Ezecarp36/RobotLaberinto_G2/README.md

# RobotLaberinto_G2
Proyecto de robot laberinto para competir en la LNR 2023
