Ezecarp36/RobotLaberinto_G2/Hardware/Design_3D/Laberinto_G2.SLDASM

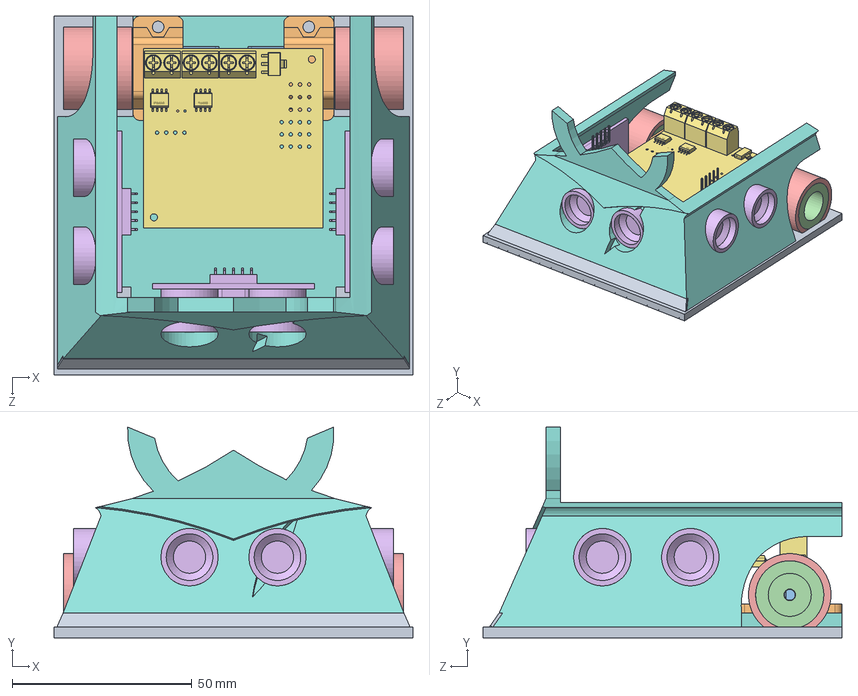
[picture p1: CAD file, 2023-11-03]
Hardware/Design_3D/Laberinto_G2.SLDASM
100.0 x 58.7 x 100.0 mm
Soporte_Motor_Pololu x 2
MicroMotor_500RPM
Llanta_V2 x 2
Cubierta_V2 x 2
UltraSonic_Sensor x 3
RobotLaberintoG2_PCB
Chasis_G2V1
Cuchilla_G2
