Ezecarp36/RobotLaberinto_G2/Hardware/Design_3D/RobotLaberintoG2_PCB.step

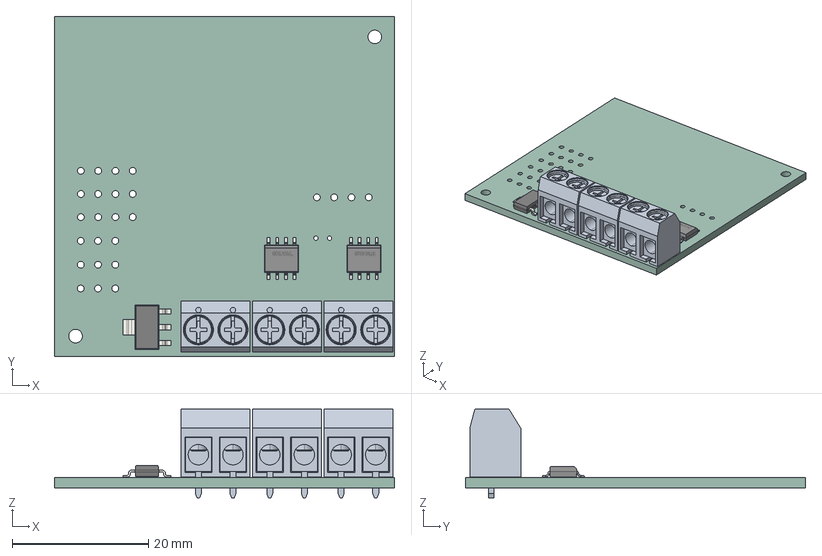
[picture p2: CAD file, 2023-11-03]
Hardware/Design_3D/RobotLaberintoG2_PCB.step
50.0 x 50.0 x 13.0 mm
PCB
