Ezecarp36/RobotLaberinto_G2/Hardware/Design_3D/Soporte_Motor_Pololu.SLDPRT

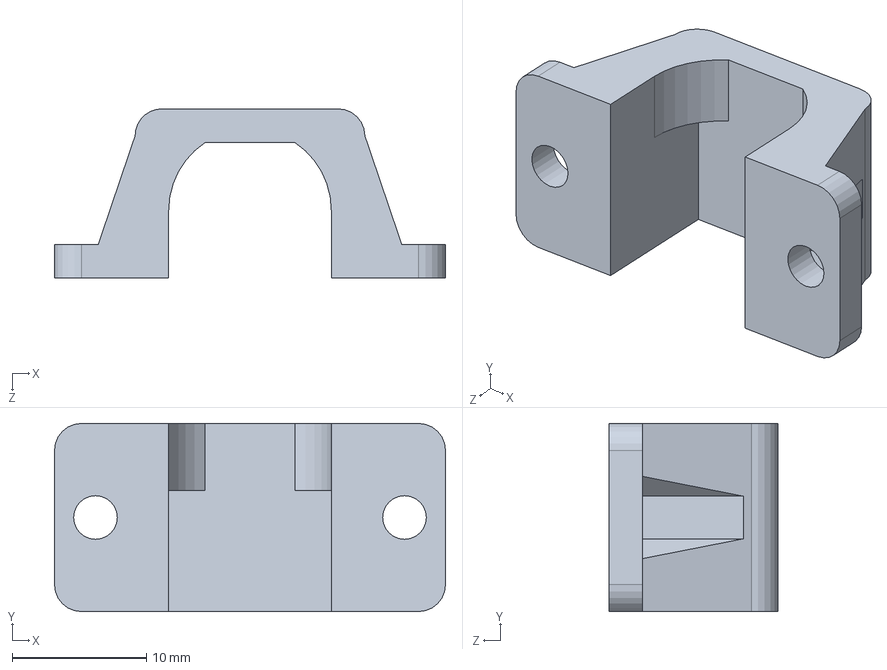
[picture p3: CAD file, 2023-11-03]
Hardware/Design_3D/Soporte_Motor_Pololu.SLDPRT
29.1 x 14.0 x 12.6 mm
