Ezecarp36/RobotLaberinto_G2/Hardware/Design_3D/UltraSonic_Sensor.SLDPRT

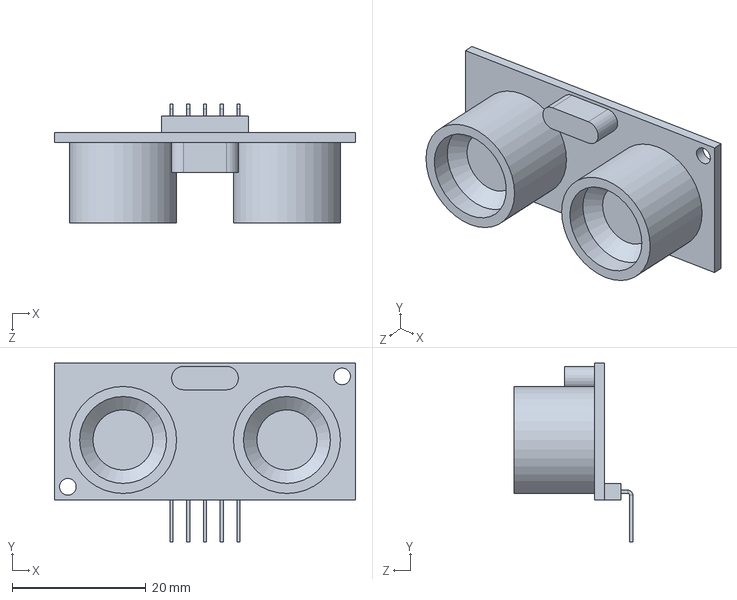
[picture p4: CAD file, 2023-11-03]
Hardware/Design_3D/UltraSonic_Sensor.SLDPRT
45.0 x 26.8 x 17.8 mm
