Ezecarp36/RobotLaberinto_G2/Hardware/Design_3D/Llanta_V2.SLDPRT

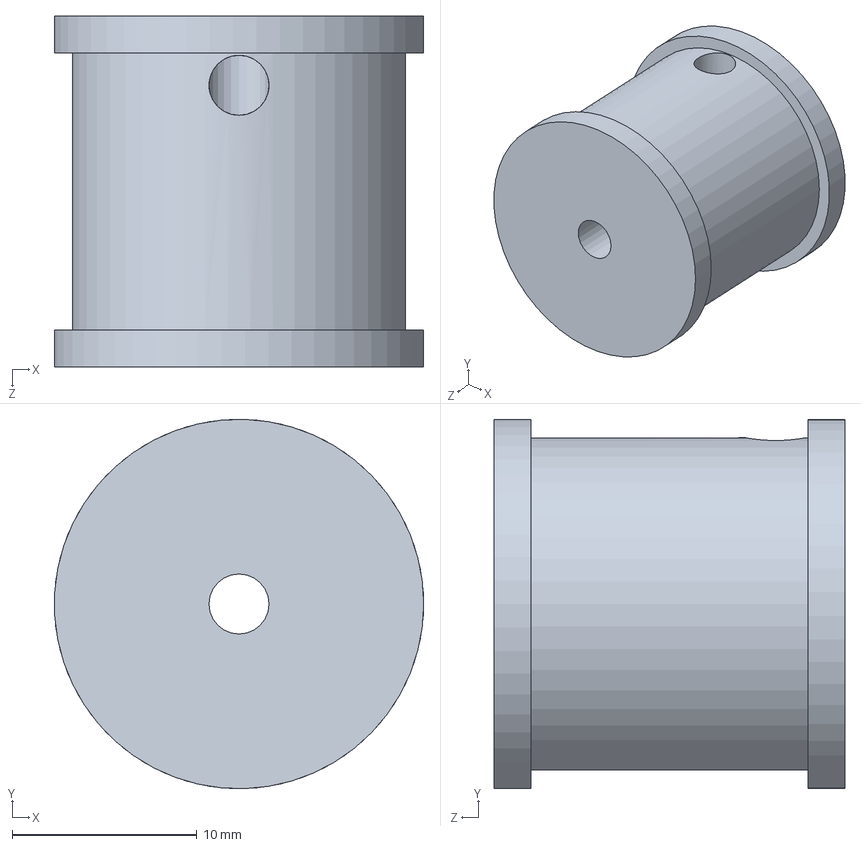
[picture p5: CAD file, 2023-11-03]
Hardware/Design_3D/Llanta_V2.SLDPRT
20.0 x 20.0 x 19.0 mm
