Ezecarp36/RobotLaberinto_G2/Hardware/Design_3D/MicroMotor_500RPM.SLDPRT

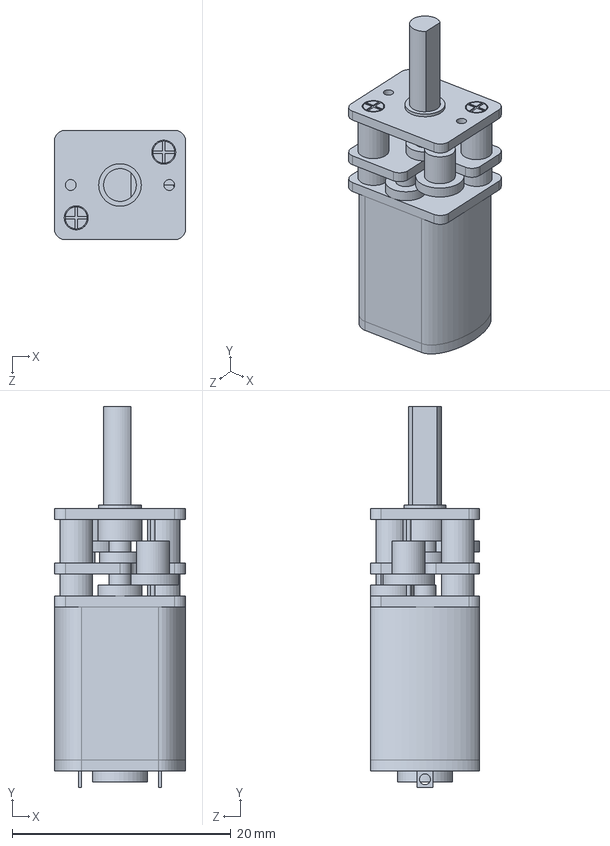
[picture p6: CAD file, 2023-11-03]
Hardware/Design_3D/MicroMotor_500RPM.SLDPRT
12.0 x 34.8 x 10.0 mm
