Ezecarp36/RobotLaberinto_G2/(list of files, cad)

Other CAD files:
Hardware/Design_3D/Guia_G2.SLDPRT
Hardware/Design_3D/Cubierta_V2.SLDPRT
Hardware/Design_3D/Cuchilla_G2.SLDPRT
Hardware/Design_3D/Chasis_G2.SLDPRT
Hardware/Design_3D/Chasis_G2V1.SLDPRT
Hardware/Design_3D/Chasis_G2V1.STL
Hardware/Design_3D/RobotLaberintoG2_PCB.SLDPRT
