Ezecarp36/RobotLaberinto_G2/Hardware/G2/G2_PCB_V2/G2_PCB_V2.kicad_pcb

## KiCad design Hardware/G2/G2_PCB_V2/G2_PCB_V2.kicad_pcb (2023-08-26)

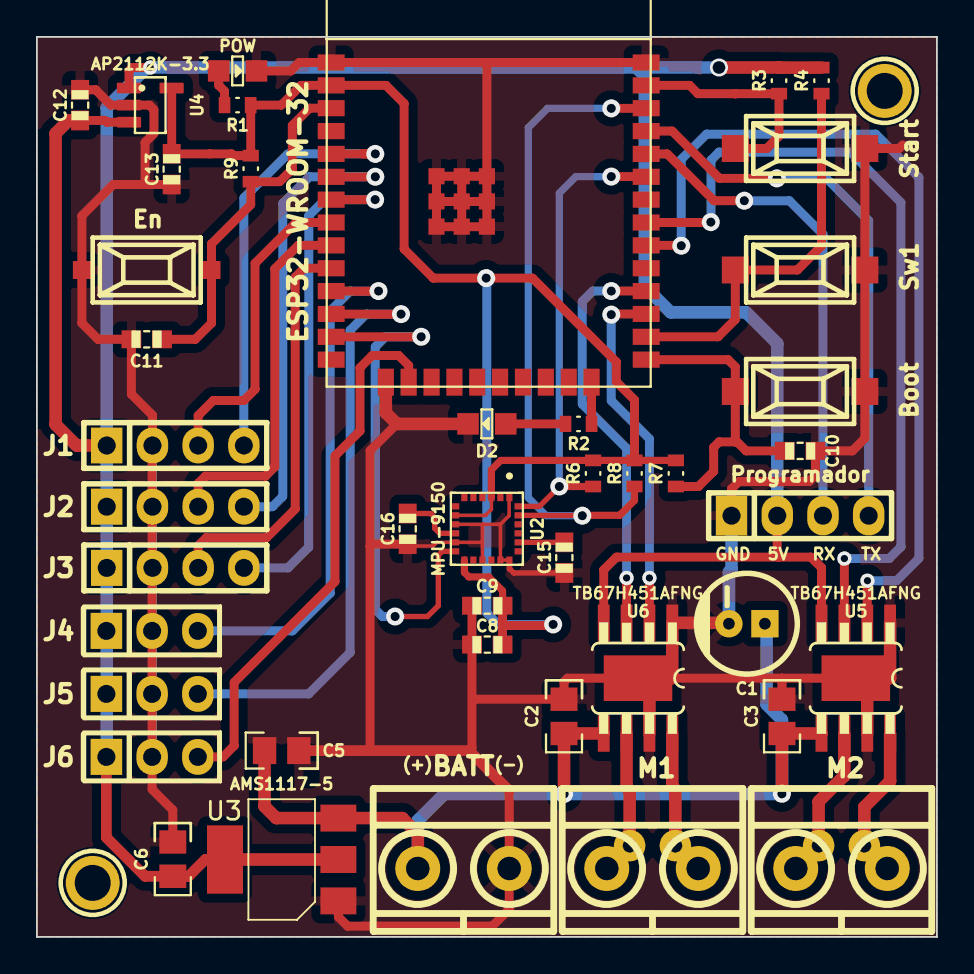
[picture p7: board G2_PCB_V2.kicad_pcb from above]

Board: 2 copper layers, 50.0 x 50.0 mm, 45 parts (0 on the bottom side), 35 nets.

Parts:
BOOT1: SW_Push; Pulsador_SMD_2_ALTO
BORNERA2, BORNERA2#2: J**; BORNERA2_DUO
C1: 100Uf/30V; CAP_ELEC_5x11mm
C2, C3: 100nf; C_0805
C5: 100nF; C_0805
C6: 10uF; C_0805
C8, C12, C16: 100nF; C_0603
C9: 10nF; C_0603
C10, C11: 1n; C_0603
C13: 10uF; C_0603
C15: 2.2nF; C_0603
EN1: SW_Push; Pulsador_SMD_2_ALTO
H1, H2: Mounting_Hole; pad_3mm
J1: Sensor1; pin_strip_4
J2: Sensor2; pin_strip_4
J3: Sensor3; pin_strip_4
J4: Sensor4; Pin_Header_3
J5: Sensor5; Pin_Header_3
J6: Sensor6; Pin_Header_3
J8: BATT; BORNERA2_AZUL
LED1: POW; Led_0805
LED2: D2; Led_0805
Programador: J7; pin_strip_4
R1, R2: 1K; R_0603
R3, R4, R6, R7, R9: 10K; R_0603
R8: 1OK; R_0603
Star1: SW_Push; Pulsador_SMD_2_ALTO
Switch1: SW_Push; Pulsador_SMD_2_ALTO
U1: ESP32-WROOM-32
U2: MPU-9150; MPU-9150-Qfn-24
U3: AMS1117-5; SOT-223-3_TabPin2
U4: AP2112K-3.3; AP2112K-3.3-Sot25
U5, U6: TB67H451AFNG

Connections:
+3V3: C8.1, C9.1, C13.2, R1.1, R6.1, R7.1, R8.2, R9.2, U1.3V3, U2.3 (VDD), U2.8 (VLOGIC), U2.13 (VDD), U4.5 (VOUT)
+5V: C6.1, C12.1, J1.1, J2.1, J3.1, J4.1, J5.1, J6.1, Programador.2, R3.2, R4.2, U3.2 (VO), U4.1 (VIN), U4.3 (EN), U5.4 (VREF), U6.4 (VREF)
/BOTON_START: R3.1, Star1.2, U1.36 (IO23)
/BOTON_SWITCH_1: R4.1, Switch1.2, U1.24 (IO4)
/EN: C11.2, EN1.2, R9.1, U1.9 (EN)
/IN1_SENSOR: J1.4, U1.8 (SENSOR_VN)
/IN2_SENSOR: J2.4, U1.10 (IO34)
/IN3_SENSOR: J3.4, U1.11 (IO35)
/INT: U1.17 (IO14), U2.12 (INT)
/IN/OUT1: J4.3, U1.15 (IO26)
/IN/OUT2: J5.3, U1.16 (IO27)
/IN/OUT3: J6.3, U1.20 (IO13)
/IO0: BOOT1.2, C10.2, R8.1, U1.23 (IO0)
/IO2: R2.2, U1.22 (IO2)
/M1_IN1: U1.38 (IO19), U5.3 (IN1)
/M1_IN2: U1.35 (IO18), U5.2 (IN2)
/M2_IN1: U1.27 (IO17), U6.3 (IN1)
/M2_IN2: U1.25 (IO16), U6.2 (IN2)
/OUT1_SENSOR: J1.3, U1.12 (IO32)
/OUT2_SENSOR: J2.3, U1.13 (IO33)
/OUT3_SENSOR: J3.3, U1.14 (IO25)
/OUT_A_M1: BORNERA2#2.2, U5.8 (OUT2)
/OUT_A_M2: BORNERA2.2, U6.8 (OUT2)
/OUT_B_M1: BORNERA2#2.1, U5.6 (OUT1)
/OUT_B_M2: BORNERA2.1, U6.6 (OUT1)
/RXD0: Programador.3, U1.40 (RXD0)
/SCL: R7.2, U1.39 (IO22), U2.23 (SCL)
/SDA: R6.2, U1.42 (IO21), U2.24 (SDA)
/TXD0: Programador.4, U1.41 (TXD0)
GND: BOOT1.1, C1.2, C2.2, C3.2, C5.2, C6.2, C8.2, C9.2, C10.1, C11.1, C12.2, C13.1, C15.1, C16.1, EN1.1, J1.2, J2.2, J3.2, J4.2, J5.2, J6.2, J8.2, LED1.2 (K), LED2.2 (K), Programador.1, Star1.1, Switch1.1, U1.GND, U2.1 (CLKIN), U2.9 (AD0), U2.11 (FSYNC), U2.15 (GND), U2.17 (GND), U2.18 (GND), U3.1 (GND), U4.2 (GND), U5.1 (GND), U5.7 (RS), U6.1 (GND), U6.7 (RS)
unnamed: LED1.1 (A), R1.2
unnamed: LED2.1 (A), R2.1
unnamed: C15.2, U2.20 (CPOUT)
unnamed: C16.2, U2.10 (REGOUT)
VCC: C1.1, C2.1, C3.1, C5.1, J8.1, U3.3 (VI), U5.5 (VM), U6.5 (VM)
