Ezecarp36/RobotLaberinto_G2/Hardware/Modulo_MPU-9150/PCB-MPU-9150/PCB-MPU-9150.kicad_pcb

## KiCad design Hardware/Modulo_MPU-9150/PCB-MPU-9150/PCB-MPU-9150.kicad_pcb (2023-08-26)

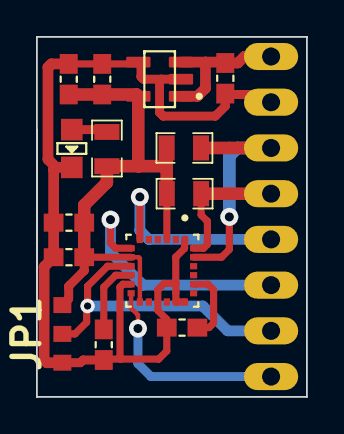
[picture p8: board PCB-MPU-9150.kicad_pcb from above]

Board: 2 copper layers, 15.0 x 20.0 mm, 15 parts (1 on the bottom side), 12 nets.

Parts:
C1: 2.2nF; C_0603
C2, C3, C5: 100nF; C_0603
C4: 10nF; C_0603
C6: 10uF; C_0603
C7: 4.7uF; C_0603
JP1: Jump; R_0805
LED1: LED; Led_0805
P1: CONN_01X08; GY-521-MPU-6050
R1, R2: 10K; R_0805
R3: 1K; R_0805
U1: MPU-9150; MPU-9150-Qfn-24
U2: AP2112K-3.3; AP2112K-3.3-Sot25

Connections:
+3.3V: C3.1, C4.1, C5.2, C6.2, JP1.3 (B), R1.1, R2.1, R3.1, U1.3 (VDD), U1.8 (VLOGIC), U1.13 (VDD), U2.5 (VOUT)
/AD0: JP1.2 (C), P1.7, U1.9 (AD0)
/INT: P1.8, U1.12 (INT)
/SCL: P1.3, R2.2, U1.23 (SCL)
/SDA: P1.4, R1.2, U1.24 (SDA)
/XCL: P1.6, U1.7 (ES_CL)
/XDA: P1.5, U1.6 (ES_DA)
GND: C1.1, C2.1, C3.2, C4.2, C5.1, C6.1, C7.2, JP1.1 (A), LED1.2 (K), P1.2, U1.1 (CLKIN), U1.11 (FSYNC), U1.15 (GND), U1.17 (GND), U1.18 (GND), U2.2 (GND)
unnamed: LED1.1 (A), R3.2
unnamed: C1.2, U1.20 (CPOUT)
unnamed: C2.2, U1.10 (REGOUT)
VCC: C7.1, P1.1, U2.1 (VIN), U2.3 (EN)
