Ezecarp36/RobotLaberinto_G2/Hardware/G2/G2_PCB_V1/G2_PCB_V1.kicad_pcb

## KiCad design Hardware/G2/G2_PCB_V1/G2_PCB_V1.kicad_pcb (2023-07-25, an earlier design)

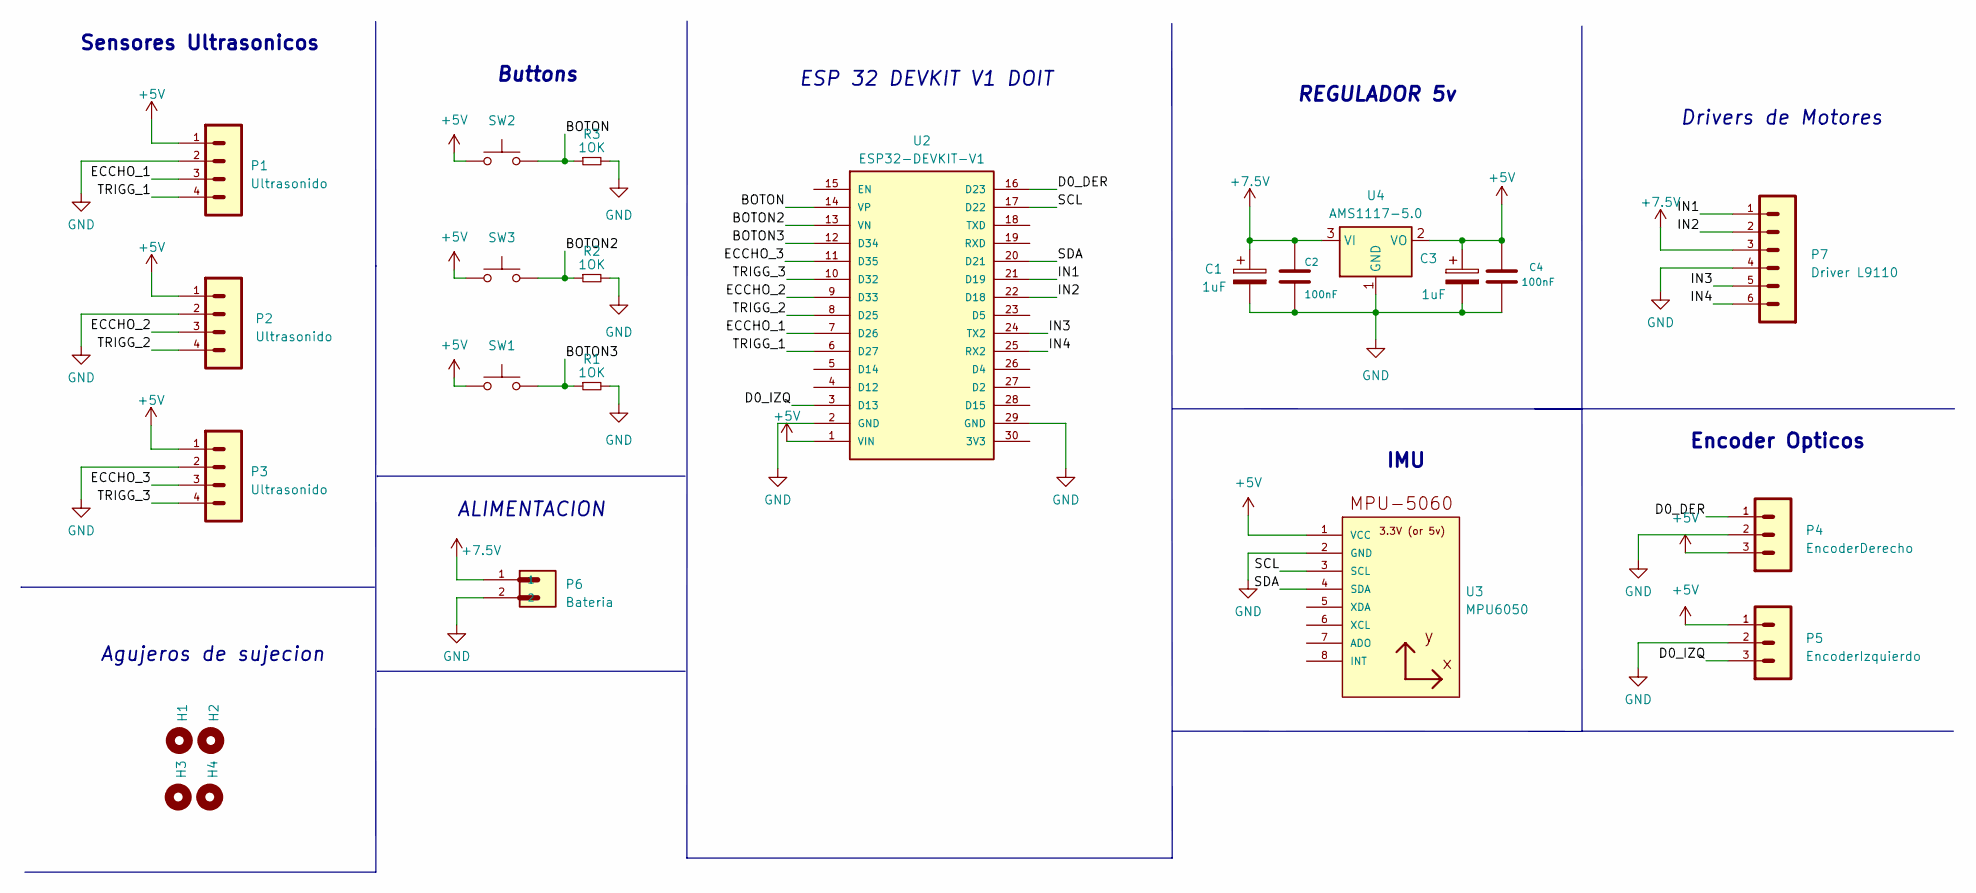
[picture p9: schematic G2_PCB_V1.kicad_sch]

Parts:
C1, C3: 1uF; C_0805
C2, C4: 100nF; C_0805
H1, H2, H3, H4: Mounting_Hole; hole_3mm
P1, P2, P3: Ultrasonido; JstXH4P
P4: EncoderDerecho; JstXH3P
P5: EncoderIzquierdo; JstXH3P
P6: Bateria; BORNERA2_AZUL
P7: Driver L9110; JstXH6P
R1, R2, R3: 1OK; R_1206
SW1, SW2, SW3: SW_Push; Pin_Header_2
U2: ESP32-DEVKIT-V1; ESP32-DEVKIT-V1-30Pines
U3: MPU6050; MPU-6050
U4: AMS1117-5.0; SOT-223-3_TabPin2

Connections:
+5V: C3.1, C4.1, P1.1, P2.1, P3.1, P4.3, P5.1, SW1.1, SW2.1, SW3.1, U2.1 (VIN), U3.1 (VCC), U4.2 (VO)
+7.5V: C1.1, C2.1, P6.1, P7.3, U4.3 (VI)
/BOTON: R3.1, SW2.2, U2.14 (VP)
/BOTON2: R2.1, SW3.2, U2.13 (VN)
/BOTON3: R1.1, SW1.2, U2.12 (D34)
/D0_DER: P4.1, U2.16 (D23)
/D0_IZQ: P5.3, U2.3 (D13)
/ECCHO_1: P1.3, U2.7 (D26)
/ECCHO_2: P2.3, U2.9 (D33)
/ECCHO_3: P3.3, U2.11 (D35)
/IN1: P7.1, U2.21 (D19)
/IN2: P7.2, U2.22 (D18)
/IN3: P7.5, U2.24 (TX2)
/IN4: P7.6, U2.25 (RX2)
/SCL: U2.17 (D22), U3.3 (SCL)
/SDA: U2.20 (D21), U3.4 (SDA)
/TRIGG_1: P1.4, U2.6 (D27)
/TRIGG_2: P2.4, U2.8 (D25)
/TRIGG_3: P3.4, U2.10 (D32)
GND: C1.2, C2.2, C3.2, C4.2, P1.2, P2.2, P3.2, P4.2, P5.2, P6.2, P7.4, R1.2, R2.2, R3.2, U2.2 (GND), U2.29 (GND), U3.2 (GND), U4.1 (GND)

Notes on the sheet:
IMU
Encoder Opticos
Agujeros de sujecion
Sensores Ultrasonicos
Drivers de Motores
Buttons
ALIMENTACION
REGULADOR 5v
ESP 32 DEVKIT V1 DOIT

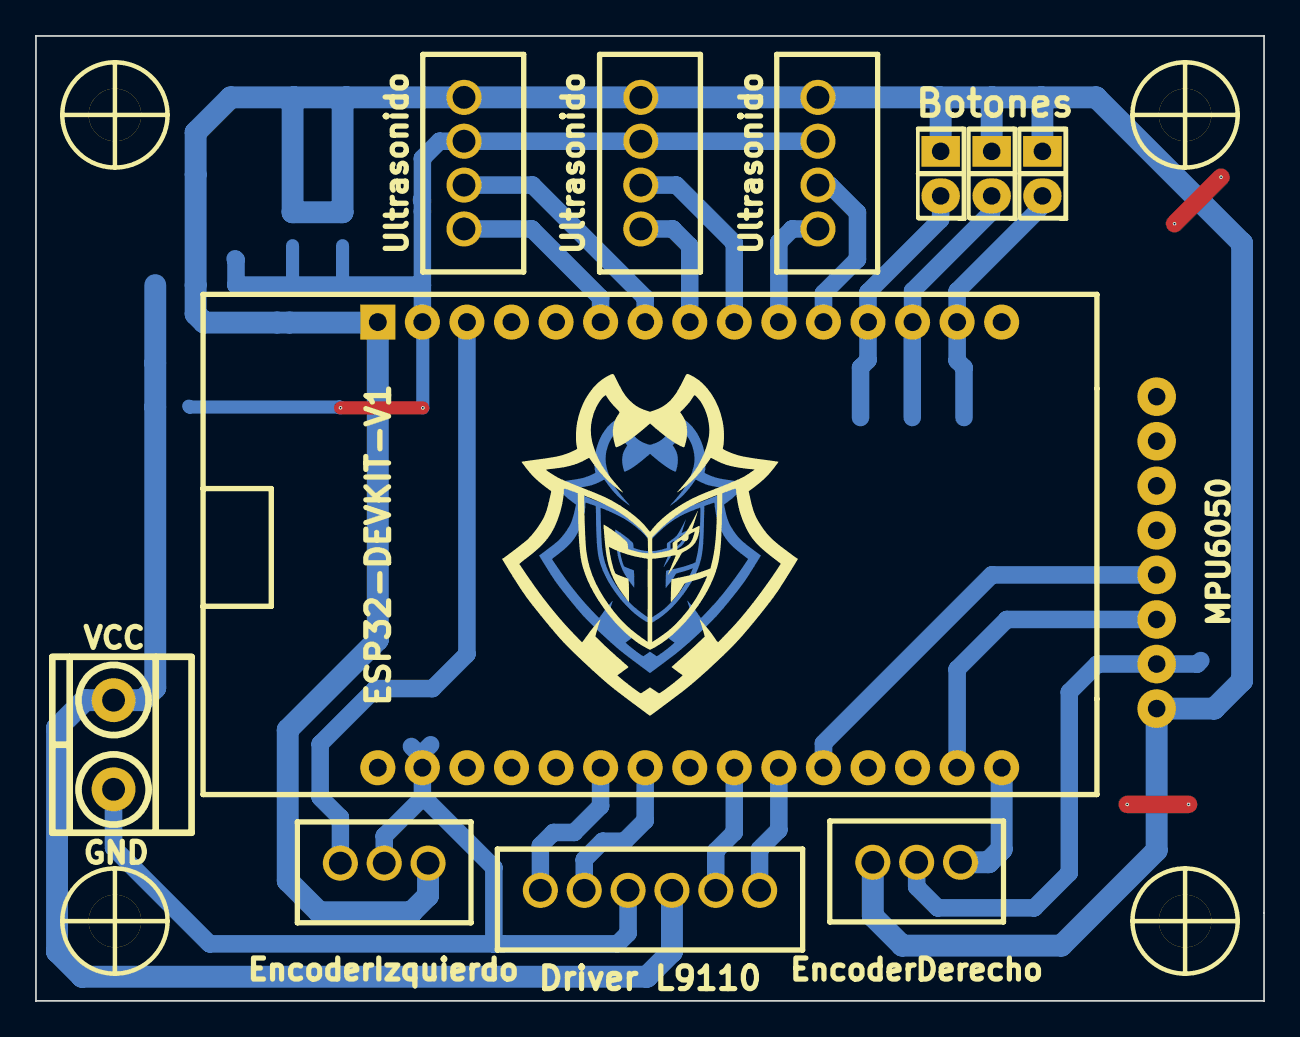
[picture p10: board G2_PCB_V1.kicad_pcb from above]

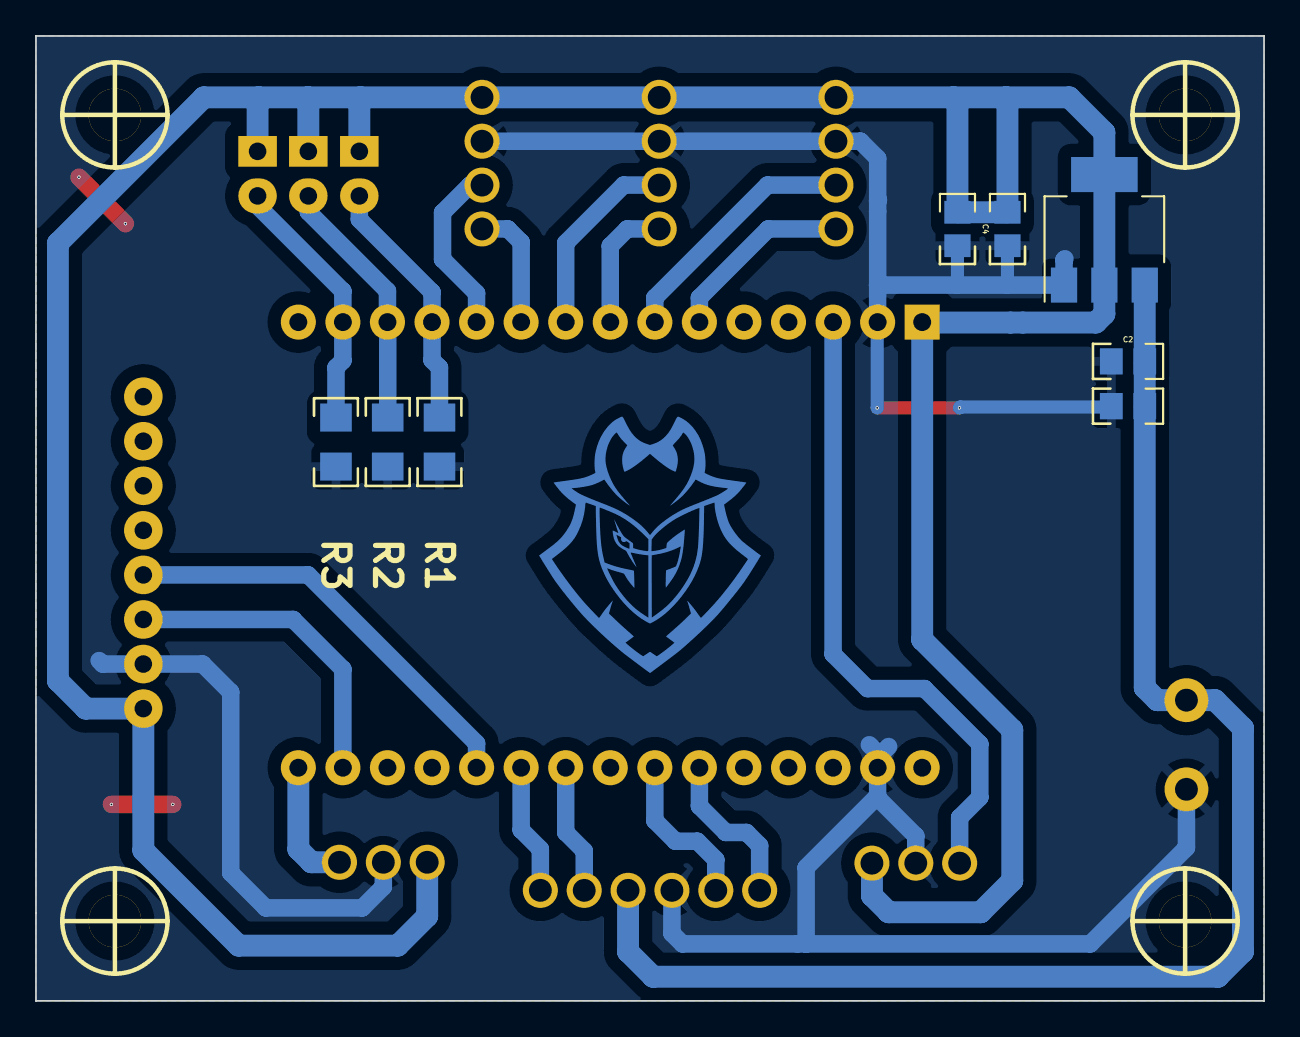
[picture p11: board G2_PCB_V1.kicad_pcb from below]

Board: 2 copper layers, 70.0 x 55.0 mm, 24 parts (8 on the bottom side), 20 nets.
