Ezecarp36/RobotLaberinto_G2/Software/Librerias/DistanceSensors/DistanceSensors.cpp

#include "DistanceSensors.h"

float Isensor::AnalogReading(int pin)
{
    int n = 3;
    long sum = 0;
    for (int i = 0; i < n; i++)
    {
        sum = sum + analogRead(pin);
    }
    float adc = sum / n;
    return adc;
}

Sharp_GP2Y0A60S::Sharp_GP2Y0A60S(int pin)
{
    sensorPin = pin;
    pinMode(sensorPin, INPUT);
}

double Sharp_GP2Y0A60S::SensorRead()
{
    float adc = AnalogReading(sensorPin);
    double distance = 187754 * pow(adc, -1.183);
    delay(100);
    return distance;
}

Sharp_GP2Y0A21::Sharp_GP2Y0A21(int pin)
{
    sensorPin = pin;
    pinMode(sensorPin, INPUT);
}

double Sharp_GP2Y0A21::SensorRead()
{
    float adc = AnalogReading(sensorPin);
    float distance = 11945.0 / (adc - 11.0);
    delay(100);
    return distance;
}

Sharp_GP2Y0A02::Sharp_GP2Y0A02(int pin)
{
    sensorPin = pin;
    pinMode(sensorPin, INPUT);
}

double Sharp_GP2Y0A02::SensorRead()
{
    float adc = AnalogReading(sensorPin);
    if (adc > 2700)
        adc = 2700;
    if (adc < 500)
        adc = 500;
    float distance = 10650.08 * (pow(adc, -0.74999)) + 1; // 254000 *(pow( adc , -1.2134));
    delay(100);
    return distance;
}

Ultrasound::Ultrasound(int trig, int echo)
{
    pinTrig = trig;
    pinEcho = echo;
    pinMode(pinEcho, INPUT);
    pinMode(pinTrig, OUTPUT);
    digitalWrite(pinTrig, LOW);
}

double Ultrasound::SensorRead()
{
    long distance;
    long pulse;
    // SENSOR
    digitalWrite(pinTrig, HIGH);
    delayMicroseconds(10); // Enviamos un pulso de 10us
    digitalWrite(pinTrig, LOW);
    pulse = pulseIn(pinEcho, HIGH);
    distance = pulse / 58.2;
    return distance;
}

VL53L0X_Sensor::VL53L0X_Sensor(int xshutPin, uint8_t address)
{
    i2cAddress = address;
    xshutPin = xshutPin;
    errorFlag = false;

    pinMode(xshutPin, OUTPUT);
    digitalWrite(xshutPin, LOW);
    delay(10);
}

bool VL53L0X_Sensor::SensorInit()
{
    digitalWrite(xshutPin, HIGH);
    delay(10);
    errorFlag = lox.begin(address, false, &Wire):
    return errorFlag;
}

double VL53L0X_Sensor::SensorRead()
{
    VL53L0X_RangingMeasurementData_t measure;
    lox.rangingTest(&measure, false);

    if (measure.RangeStatus != 4)
        return measure.RangeMilliMeter;

    else
        return -1; // Indica error
}

bool VL53L0X_Sensor::GetErrorFlag()
{
    return errorFlag;
}

void VL53L0X_Sensor::SensorOff()
{
    digitalWrite(xshutPin, LOW);
    delay(10);
}

void VL53L0X_Sensor::SensorOn()
{
    digitalWrite(xshutPin, HIGH);
    delay(10);
}
