Ezecarp36/RobotLaberinto_G2/(commit log)

2023-06-09 PCB de G2 version 1 terminado
    [G2_PCB_V1.kicad_pcb, G2_PCB_V1.kicad_sch]
2023-07-25 comence a desarrollar un modulo para la mpu9150, PCB terminado listo para fabricar y probar su funcionamiento
    [G2_PCB_V1.kicad_pcb, G2_PCB_V1.kicad_sch, PCB-MPU-9150.kicad_pcb, PCB-MPU-9150.kicad_sch]
2023-08-04 empece el nuevo diseño para el robot laberinto G2
    [G2_PCB_V1.kicad_pcb, G2_PCB_V1.kicad_sch, G2_PCB_V2.kicad_pcb, G2_PCB_V2.kicad_sch]
2023-08-26 agregue la version final de la mpu9150 y la version final del Pla version 2 del PCB
    [G2_PCB_V2.kicad_pcb, G2_PCB_V2.kicad_sch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]
2023-11-03 agregue el codigo de laberinto
2023-11-03 Agregue los modelos 3D
    [Chasis_G2.SLDPRT, Chasis_G2V1.SLDPRT, Chasis_G2V1.STL, Cubierta_V2.SLDPRT, Cuchilla_G2.SLDPRT, Guia_G2.SLDPRT, Laberinto_G2.SLDASM, Llanta_V2.SLDPRT]
2025-05-04 Agregue a mi liberia de sensores la clase del sensor laser VL53L0X y cree un codigo de ejemplo de su uso en la carpeta examples de la libreria
2025-05-05 agregue el codigo de prueba de los sensores VL53L0X en el robot y modifique el codigo de prueba del PID para poder usarlo con dichos sensores
2025-05-06 fix sensor init functions
    [DistanceSensors.cpp, DistanceSensors.h, PruebaVL53L0X.ino]
